trystendsmyth/nest-mini-drop-in-pcb/nest-mini-v2-drop-in-pcb.kicad_pcb

## KiCad design nest-mini-v2-drop-in-pcb.kicad_pcb (2026-09-27)

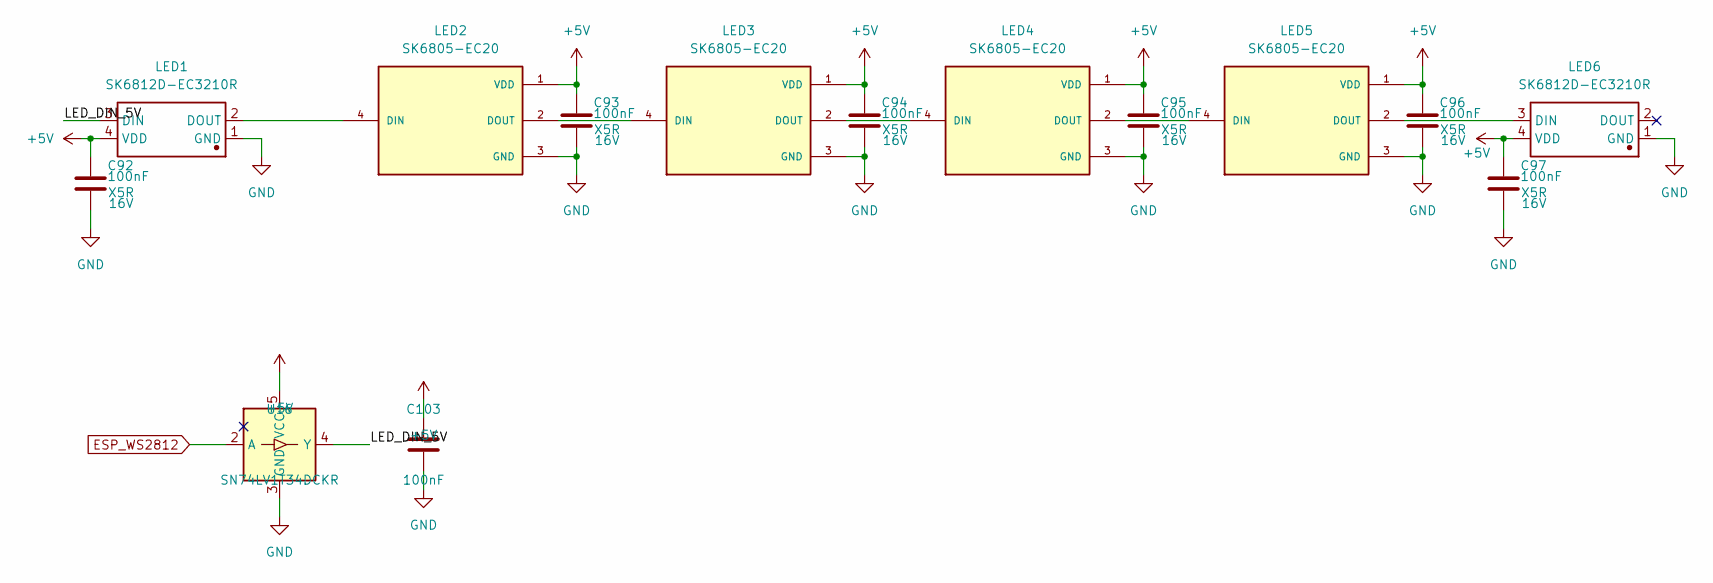
[picture p1: schematic leds.kicad_sch, Drop in replacement PCB for Nest mini GEN2]

Parts:
C92, C93, C94, C95, C96, C97: 100nF; C_0402_1005Metric; Voltage 16V; LCSC Part # C1525
C103: 100nF; C_0402_1005Metric; Manufacturer Part CL05B104KO5NNNC; LCSC Part # C1525
LED1, LED6: SK6812D-EC3210R; LED-SMD_4P_SK6812D-EC3210R; Manufacturer Part SK6812D-EC3210R; LCSC Part # C2890041
LED2, LED3, LED4, LED5: SK6805-EC20; Manufacturer Part SK6805-EC20; LCSC Part # C2890036
U16: SN74LV1T34DCKR; SOT-353_SC-70-5; MPN SN74LV1T34DCKR; LCSC Part # C78541

Connections:
+5V: C92.1, C93.1, C94.1, C95.1, C96.1, C97.1, C103.1, LED1.4 (VDD), LED2.1 (VDD), LED3.1 (VDD), LED4.1 (VDD), LED5.1 (VDD), LED6.4 (VDD), U16.5 (VCC); also elsewhere on the board
/LEDs/LED_DIN_5V: LED1.3 (DIN), U16.4 (Y)
ESP_WS2812: U16.2 (A); also elsewhere on the board
GND: C92.2, C93.2, C94.2, C95.2, C96.2, C97.2, C103.2, LED1.1 (GND), LED2.3 (GND), LED3.3 (GND), LED4.3 (GND), LED5.3 (GND), LED6.1 (GND), U16.3 (GND); also elsewhere on the board
unnamed: LED1.2 (DOUT), LED2.4 (DIN)
unnamed: LED2.2 (DOUT), LED3.4 (DIN)
unnamed: LED3.2 (DOUT), LED4.4 (DIN)
unnamed: LED4.2 (DOUT), LED5.4 (DIN)
unnamed: LED5.2 (DOUT), LED6.3 (DIN)

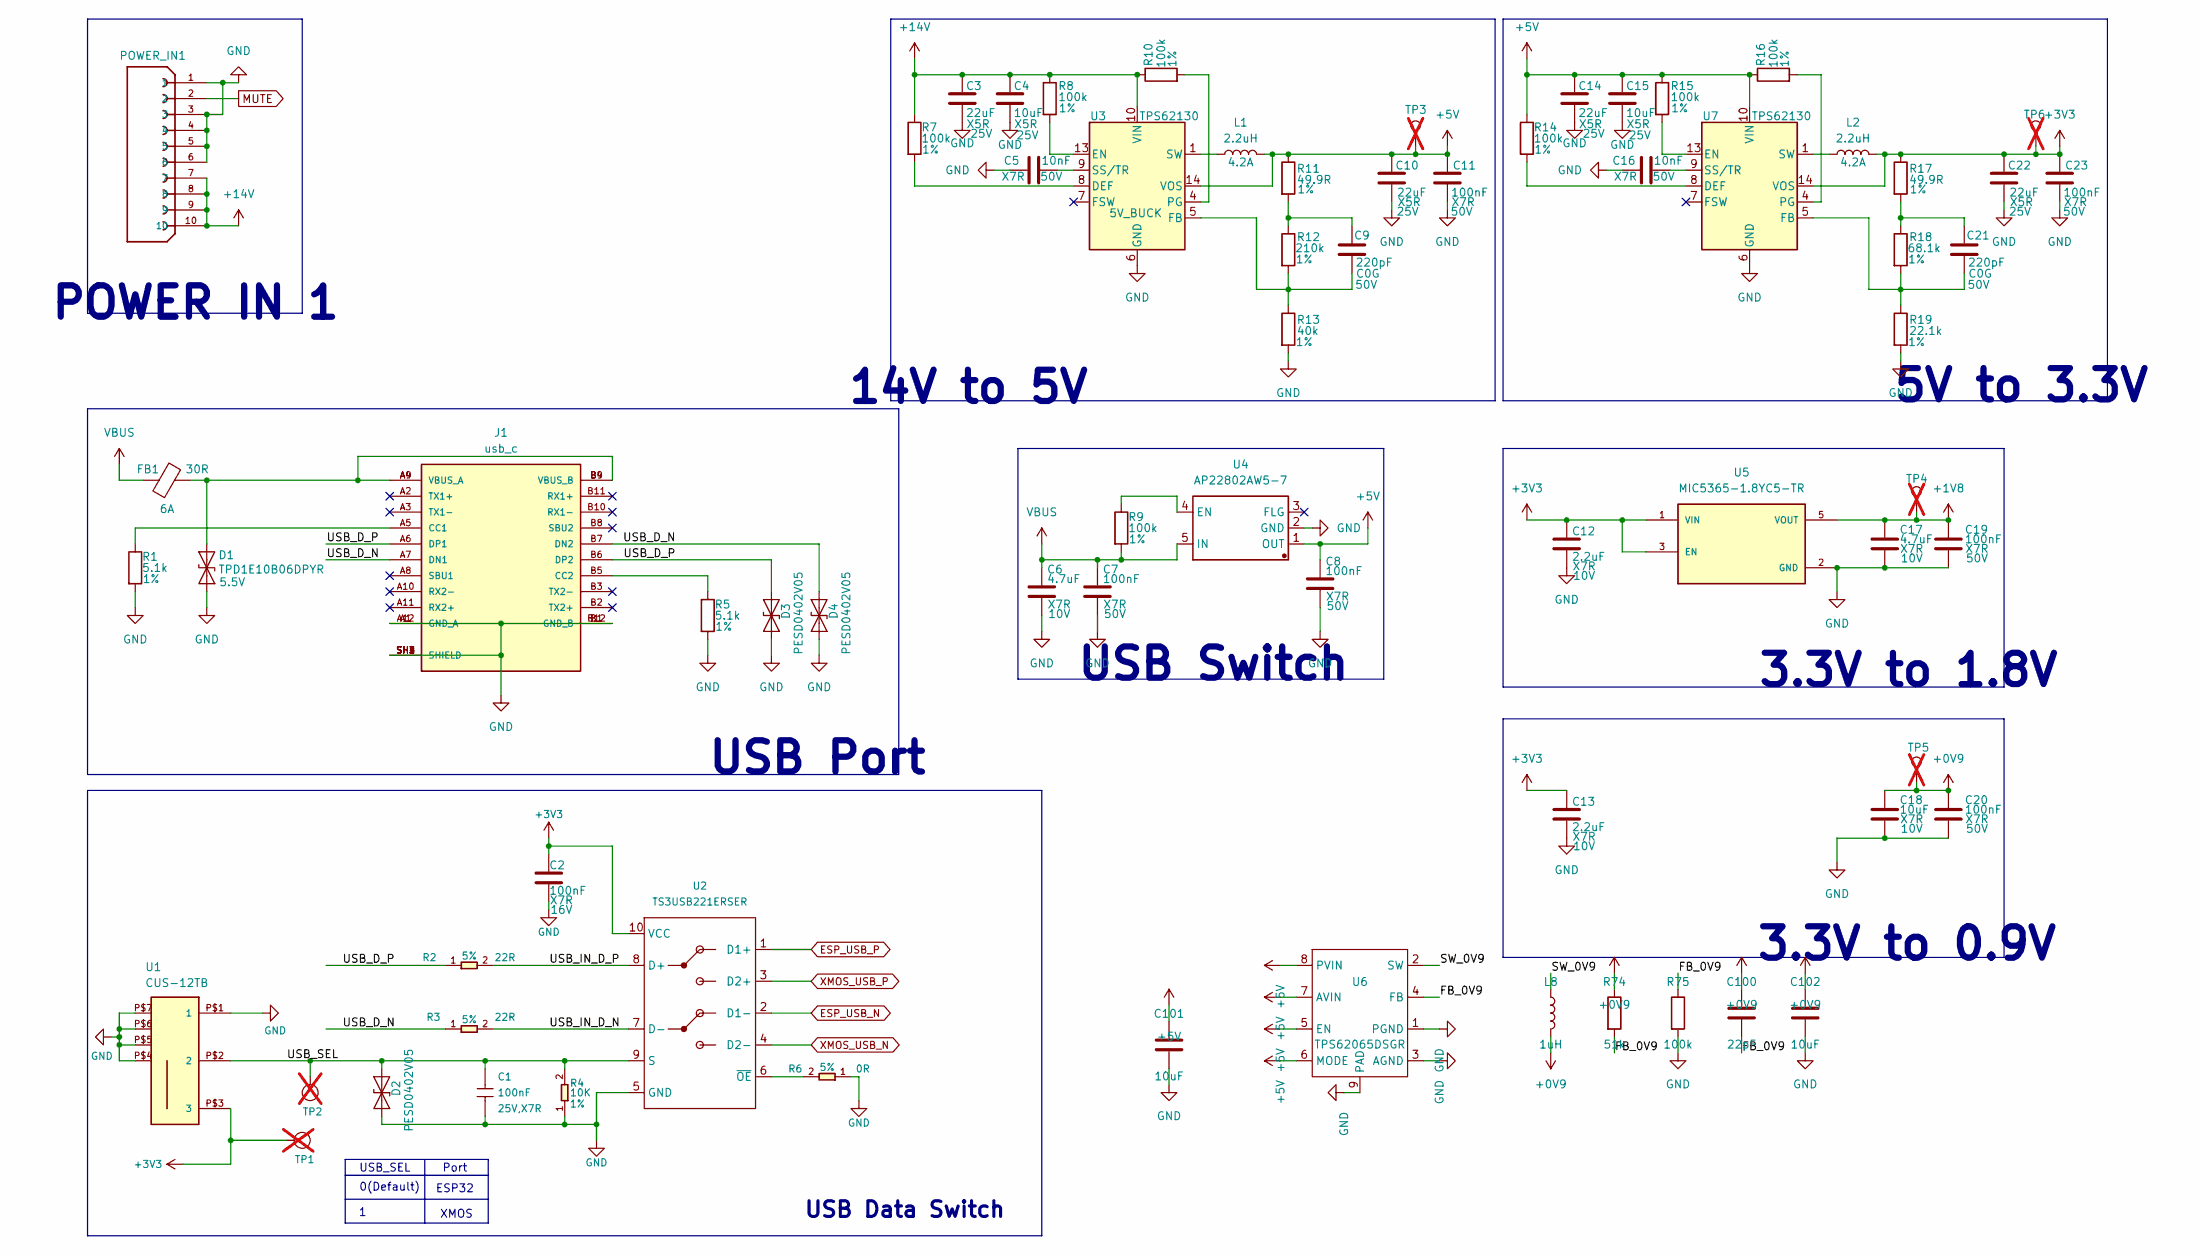
[picture p2: schematic power_handling.kicad_sch, Drop in replacement PCB for Nest mini GEN2]

Parts:
C1: 100nF; C_0402_1005Metric; Voltage Rating 25V,X7R; MPN CC0402KRX7R8BB104
C2: 100nF; C_0402_1005Metric; Voltage 16V; Manufacturer Part CL05B104KO5NNNC; LCSC Part # C1525
C3, C10, C14, C22: 22uF; C_0805_2012Metric; Voltage 25V; Manufacturer Part CL21A226MAQNNNE; LCSC Part # C45783
C4, C15: 10uF; C_0805_2012Metric; Voltage 25V; Manufacturer Part CL21A106KAYNNNE; LCSC Part # C15850
C5, C16: 10nF; C_0402_1005Metric; Voltage 50V; Manufacturer Part CL05B103KB5NNNC; LCSC Part # C15195
C6, C17: 4.7uF; C_0603_1608Metric; Voltage 10V; Manufacturer Part GRM188Z71A475KE15D; LCSC Part # C913474
C7, C8: 100nF; C_0603_1608Metric; Voltage 50V; Manufacturer Part CC0603KRX7R9BB104; LCSC Part # C14663
C9, C21: 220pF; C_0603_1608Metric; Voltage 50V; Manufacturer Part 0603CG221J500NT; LCSC Part # C156398
C11, C19, C20, C23: 100nF; C_0805_2012Metric; Voltage 50V; Manufacturer Part CC0805KRX7R9BB104; LCSC Part # C49678
C12, C13: 2.2uF; C_0603_1608Metric; Voltage 10V; Manufacturer Part GRM188R71A225KE15D; LCSC Part # C86018
C18, C101, C102: 10uF; C_0603_1608Metric; Voltage 10V; Manufacturer Part CL10A106KP8NNNC; LCSC Part # C19702
C100: 22pF; C_0402_1005Metric; Manufacturer Part CC0402JRNPO9BN220; LCSC Part # C106203
D1: TPD1E10B06DPYR; TPD1E05U06DPYR; Voltage 5.5V; Manufacturer Part TPD1E10B06DPYR; LCSC Part # C48260
D2, D4: PESD0402V05; D_0402_1005Metric; Manufacturer Part PESD0402V05; LCSC Part # C19626254
D3: PESD0402V05; D_0402_1005Metric; Part C19626254; LCSC Part # C19626254
FB1: 30R; R_0603_1608Metric; Part number BLM18PG300SN1D; LCSC Part # C17305
J1: usb_c; USB-C-SMD_TYPE-C-USB-18; Manufacturer Part 1054500101; LCSC Part # C134092
L1, L2: 2.2uH; L_Cenker_CKCS4020; Manufacturer Part SRP4020TA-2R2M; LCSC Part # C719179
L8: 1uH; L_Murata_DFE201610P; Manufacturer Part DFE201610E-1R0M=P2; LCSC Part # C161082
POWER_IN1: FH34SRJ-10S-0.5SH_50_; HRS_FH34SRJ-10S-0.5SH_50_; Manufacturer Part FH34SRJ-10S-0.5SH(50); LCSC Part # C324723
R1, R5: 5.1k; R_0402_1005Metric; Tolerance 1%; Manufacturer Part 0402WGF5101TCE; LCSC Part # C25905
R2, R3: 22R; R_0402_1005Metric; Tolerance 5%; MPN RC0402JR-0722RL
R4: 10K; R_0402_1005Metric; Tolerance 1%; MPN RC0402FR-0710KL
R6: 0R; R_0402_1005Metric; Tolerance 5%; MPN RC0402JR-070RL
R7, R8, R9, R10, R14, R15, R16: 100k; R_0402_1005Metric; Tolerance 1%; Manufacturer Part 0402WGJ0104TCE; LCSC Part # C25530
R11, R17: 49.9R; R_0603_1608Metric; Tolerance 1%; Manufacturer Part 0603WAF499JT5E; LCSC Part # C23185
R12: 210k; R_0603_1608Metric; Tolerance 1%; Manufacturer Part 0603WAF2103T5E; LCSC Part # C22952
R13: 40k; R_0603_1608Metric; Tolerance 1%; Manufacturer Part SCR0603F40K; LCSC Part # C3016445
R18: 68.1k; R_0603_1608Metric; Tolerance 1%; Manufacturer Part 0603WAF6812T5E; LCSC Part # C25976
R19: 22.1k; R_0603_1608Metric; Tolerance 1%; Manufacturer Part 0603WAF2212T5E; LCSC Part # C25961
R74: 51k; R_0402_1005Metric; Manufacturer Part RC0402FR-0751KL; LCSC Part # C107229
R75: 100k; R_0402_1005Metric; Manufacturer Part RC0402FR-07100KL; LCSC Part # C60491
TP1: Test Point; TestPoint_Pad_D1.0mm; not fitted
TP2: Test Point; TestPoint_Pad_D1.0mm; Part Type Test Point; not fitted
TP3, TP4, TP5, TP6: TestPoint; TestPoint_Pad_D1.0mm; not fitted
U1: CUS-12TB; CUS-12B
U2: TS3USB221ERSER; MPN TS3USB221ERSER; LCSC Part # C129313
U3, U7: TPS62130; VQFN-16-1EP_3x3mm_P0.5mm_EP1.68x1.68mm_ThermalVias; Manufacturer Part TPS62130ARGTR; LCSC Part # C337502
U4: AP22802AW5-7; SOT-23-5; Manufacturer Part AP22802AW5-7; LCSC Part # C211404
U5: MIC5365-1.8YC5-TR; SOT65P210X110-5N; PARTREV 3.1 - July 16, 2013; LCSC Part # C626087
U6: TPS62065DSGR; Texas_DSG0008A_WSON-8-1EP_2x2mm_P0.5mm_EP0.9x1.6mm; MPN TPS62065DSGR; LCSC Part # C398352

Connections:
+0V9: C18.1, C20.1, C100.1, C102.1, L8.2, R74.1, TP5.1; also elsewhere on the board
+1V8: C17.1, C19.1, TP4.1, U5.5 (VOUT); also elsewhere on the board
+3V3: C2.1, C12.1, C13.1, C22.1, C23.1, L2.2, R17.1, TP1.1 (T), TP6.1, U1.P$3 (3), U2.10 (VCC), U5.1 (VIN), U5.3 (EN), U7.14 (VOS); also elsewhere on the board
+5V: C8.1, C10.1, C11.1, C14.1, C15.1, C101.1, L1.2, R11.1, R14.1, R15.1, R16.1, TP3.1, U3.14 (VOS), U4.1 (OUT), U6.5 (EN), U6.6 (MODE), U6.7 (AVIN), U6.8 (PVIN), U7.10 (VIN), U7.11 (VIN), U7.12 (VIN); also elsewhere on the board
+14V: C3.1, C4.1, POWER_IN1.7, POWER_IN1.8, POWER_IN1.9, POWER_IN1.10, R7.1, R8.1, R10.1, U3.10 (VIN), U3.11 (VIN), U3.12 (VIN); also elsewhere on the board
/Power/FB_0V9: C100.2, R74.2, R75.1, U6.4 (FB)
/Power/SW_0V9: L8.1, U6.2 (SW)
/Power/USB_D_N: D4.2 (A2), J1.A7 (DN1), J1.B7 (DN2), R3.1
/Power/USB_D_P: D3.2 (A2), J1.A6 (DP1), J1.B6 (DP2), R2.1
/Power/USB_IN_D_N: R3.2, U2.7 (D-)
/Power/USB_IN_D_P: R2.2, U2.8 (D+)
/Power/USB_SEL: C1.1, D2.2 (A2), R4.2, TP2.1 (T), U1.P$2 (2), U2.9 (S)
ESP_USB_N: U2.2 (D1-); also elsewhere on the board
ESP_USB_P: U2.1 (D1+); also elsewhere on the board
GND: C1.2, C2.2, C3.2, C4.2, C5.1, C6.2, C7.2, C8.2, C10.2, C11.2, C12.2, C13.2, C14.2, C15.2, C16.1, C17.2, C18.2, C19.2, C20.2, C22.2, C23.2, C101.2, C102.2, D1.1 (A1), D2.1 (A1), D3.1 (A1), D4.1 (A1), J1.A1 (GND_A), J1.A12 (GND_A), J1.B1 (GND_B), J1.B12 (GND_B), J1.SH1 (SHIELD), J1.SH2 (SHIELD), J1.SH3 (SHIELD), J1.SH4 (SHIELD), POWER_IN1.1, POWER_IN1.3, POWER_IN1.4, POWER_IN1.5, POWER_IN1.6, R1.2, R4.1, R5.2, R6.1, R13.2, R19.2, R75.2, U1.P$1 (1), U1.P$4, U1.P$5, U1.P$6, U1.P$7, U2.5 (GND), U3.6 (GND), U3.15 (GND), U3.16 (GND), U3.17 (GND), U4.2 (GND), U5.2 (GND), U6.1 (PGND), U6.3 (AGND), U6.9 (PAD), U7.6 (GND), U7.15 (GND), U7.16 (GND), U7.17 (GND); also elsewhere on the board
MUTE: POWER_IN1.2; also elsewhere on the board
unnamed: C9.1, R11.2, R12.1
unnamed: C21.1, R17.2, R18.1
unnamed: D1.2 (A2), FB1.2, J1.A4 (VBUS_A), J1.A9 (VBUS_A), J1.B4 (VBUS_B), J1.B9 (VBUS_B)
unnamed: J1.A5 (CC1), R1.1
unnamed: J1.B5 (CC2), R5.1
unnamed: L1.1, U3.1 (SW), U3.2 (SW), U3.3 (SW)
unnamed: L2.1, U7.1 (SW), U7.2 (SW), U7.3 (SW)
unnamed: R6.2, U2.6 (~OE)
unnamed: R7.2, U3.8 (DEF)
unnamed: R8.2, U3.13 (EN)
unnamed: C9.2, R12.2, R13.1, U3.5 (FB)
unnamed: R10.2, U3.4 (PG)
unnamed: C5.2, U3.9 (SS/TR)
unnamed: R9.1, U4.4 (EN)
unnamed: R14.2, U7.8 (DEF)
unnamed: R15.2, U7.13 (EN)
unnamed: C21.2, R18.2, R19.1, U7.5 (FB)
unnamed: R16.2, U7.4 (PG)
unnamed: C16.2, U7.9 (SS/TR)
VBUS: C6.1, C7.1, FB1.1, R9.2, U4.5 (IN); also elsewhere on the board
XMOS_USB_N: U2.4 (D2-); also elsewhere on the board
XMOS_USB_P: U2.3 (D2+); also elsewhere on the board

Notes on the sheet:
USB Port
POWER IN 1
USB_SEL
14V to 5V
USB Switch
USB Data Switch
3.3V to 1.8V
ESP32
0(Default)
5V to 3.3V
3.3V to 0.9V
Port
XMOS

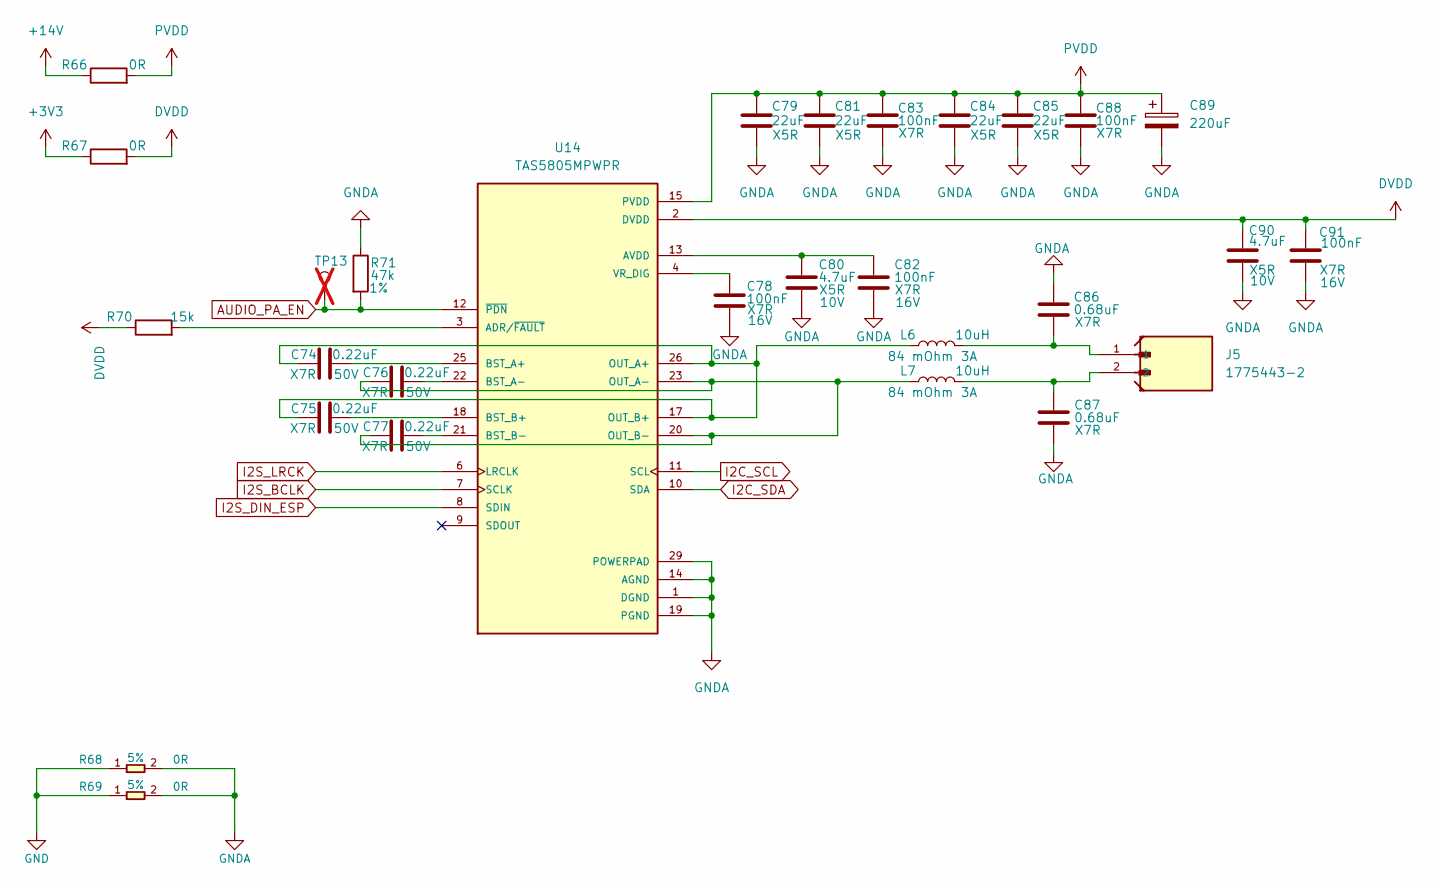
[picture p3: schematic audio.kicad_sch, Drop in replacement PCB for Nest mini GEN2]

Parts:
C74, C75, C76, C77: 0.22uF; C_0603_1608Metric; Voltage 50V
C78: 100nF; C_0402_1005Metric; Voltage 16V; Manufacturer Part CL05B104KO5NNNC; LCSC Part # C1525
C79, C81, C84, C85: 22uF; C_0805_2012Metric; Voltage 25V; Manufacturer Part GRM21BR61E226ME44L; LCSC Part # C86816
C80, C90: 4.7uF; C_0603_1608Metric; Voltage 10V
C82, C91: 100nF; C_0603_1608Metric; Voltage 16V
C83, C88: 100nF; C_0402_1005Metric; Voltage 50V; Manufacturer Part CC0402KRX7R9BB104; LCSC Part # C131394
C86, C87: 0.68uF; C_0805_2012Metric; Voltage 100V; Manufacturer Part GRM188R72A10
C89: 220uF; C_Elec_6.3x7.7; Voltage 25V; Manufacturer Part MA25V220M6X8; LCSC Part # C46550464
J5: 1775443-2; PARTREV B5; LCSC Part # C5162845
L6, L7: 10uH; XAL4040-103MEC
R66: 0R; R_1206_3216Metric
R67: 0R; R_0603_1608Metric
R68, R69: 0R; R_0805_2012Metric; Tolerance 5%; MPN 0402WGF0000TCE; LCSC Part # C17168
R70: 15k; R_0402_1005Metric; Manufacturer Part 0402WGF1502TCE; LCSC Part # C25756
R71: 47k; R_0402_1005Metric; Tolerance 1%; Manufacturer Part 0402WGF4702TCE; LCSC Part # C25792
TP13: TestPoint; TestPoint_Pad_D1.0mm; not fitted
U14: TAS5805MPWPR; Manufacturer Part TAS5805MPWPR; LCSC Part # C478472

Connections:
+3V3: R67.1; also elsewhere on the board
+14V: R66.1; also elsewhere on the board
AUDIO_PA_EN: R71.2, TP13.1, U14.12 (~PDN); also elsewhere on the board
DVDD: C90.1, C91.1, R67.2, R70.1, U14.2 (DVDD)
GND: R68.1, R69.1; also elsewhere on the board
GNDA: C78.2, C79.2, C80.2, C81.2, C82.2, C83.2, C84.2, C85.2, C86.2, C87.2, C88.2, C89.2, C90.2, C91.2, R68.2, R69.2, R71.1, U14.1 (DGND), U14.5 (DGND), U14.14 (AGND), U14.19 (PGND), U14.24 (PGND), U14.29 (POWERPAD), U14.30 (POWERPAD), U14.31 (POWERPAD), U14.32 (POWERPAD), U14.33 (POWERPAD), U14.34 (POWERPAD), U14.35 (POWERPAD), U14.36 (POWERPAD), U14.37 (POWERPAD), U14.38 (POWERPAD), U14.39 (POWERPAD), U14.40 (POWERPAD), U14.41 (POWERPAD), U14.42 (POWERPAD), U14.43 (POWERPAD), U14.44 (POWERPAD), U14.45 (POWERPAD), U14.46 (POWERPAD), U14.47 (POWERPAD), U14.48 (POWERPAD), U14.49 (POWERPAD), U14.50 (POWERPAD), U14.51 (POWERPAD), U14.52 (POWERPAD), U14.53 (POWERPAD)
I2C_SCL: U14.11 (SCL); also elsewhere on the board
I2C_SDA: U14.10 (SDA); also elsewhere on the board
I2S_BCLK: U14.7 (SCLK); also elsewhere on the board
I2S_DIN_ESP: U14.8 (SDIN); also elsewhere on the board
I2S_LRCK: U14.6 (LRCLK); also elsewhere on the board
unnamed: C86.1, J5.1, L6.2
unnamed: C87.1, J5.2, L7.2
unnamed: R70.2, U14.3 (ADR/~FAULT)
unnamed: C80.1, C82.1, U14.13 (AVDD)
unnamed: C74.2, U14.25 (BST_A+)
unnamed: C76.2, U14.22 (BST_A-)
unnamed: C75.2, U14.18 (BST_B+)
unnamed: C77.2, U14.21 (BST_B-)
unnamed: C74.1, C75.1, L6.1, U14.17 (OUT_B+), U14.26 (OUT_A+)
unnamed: C76.1, C77.1, L7.1, U14.20 (OUT_B-), U14.23 (OUT_A-)
unnamed: C78.1, U14.4 (VR_DIG)
PVDD: C79.1, C81.1, C83.1, C84.1, C85.1, C88.1, C89.1, R66.2, U14.15 (PVDD), U14.16 (PVDD), U14.27 (PVDD), U14.28 (PVDD)

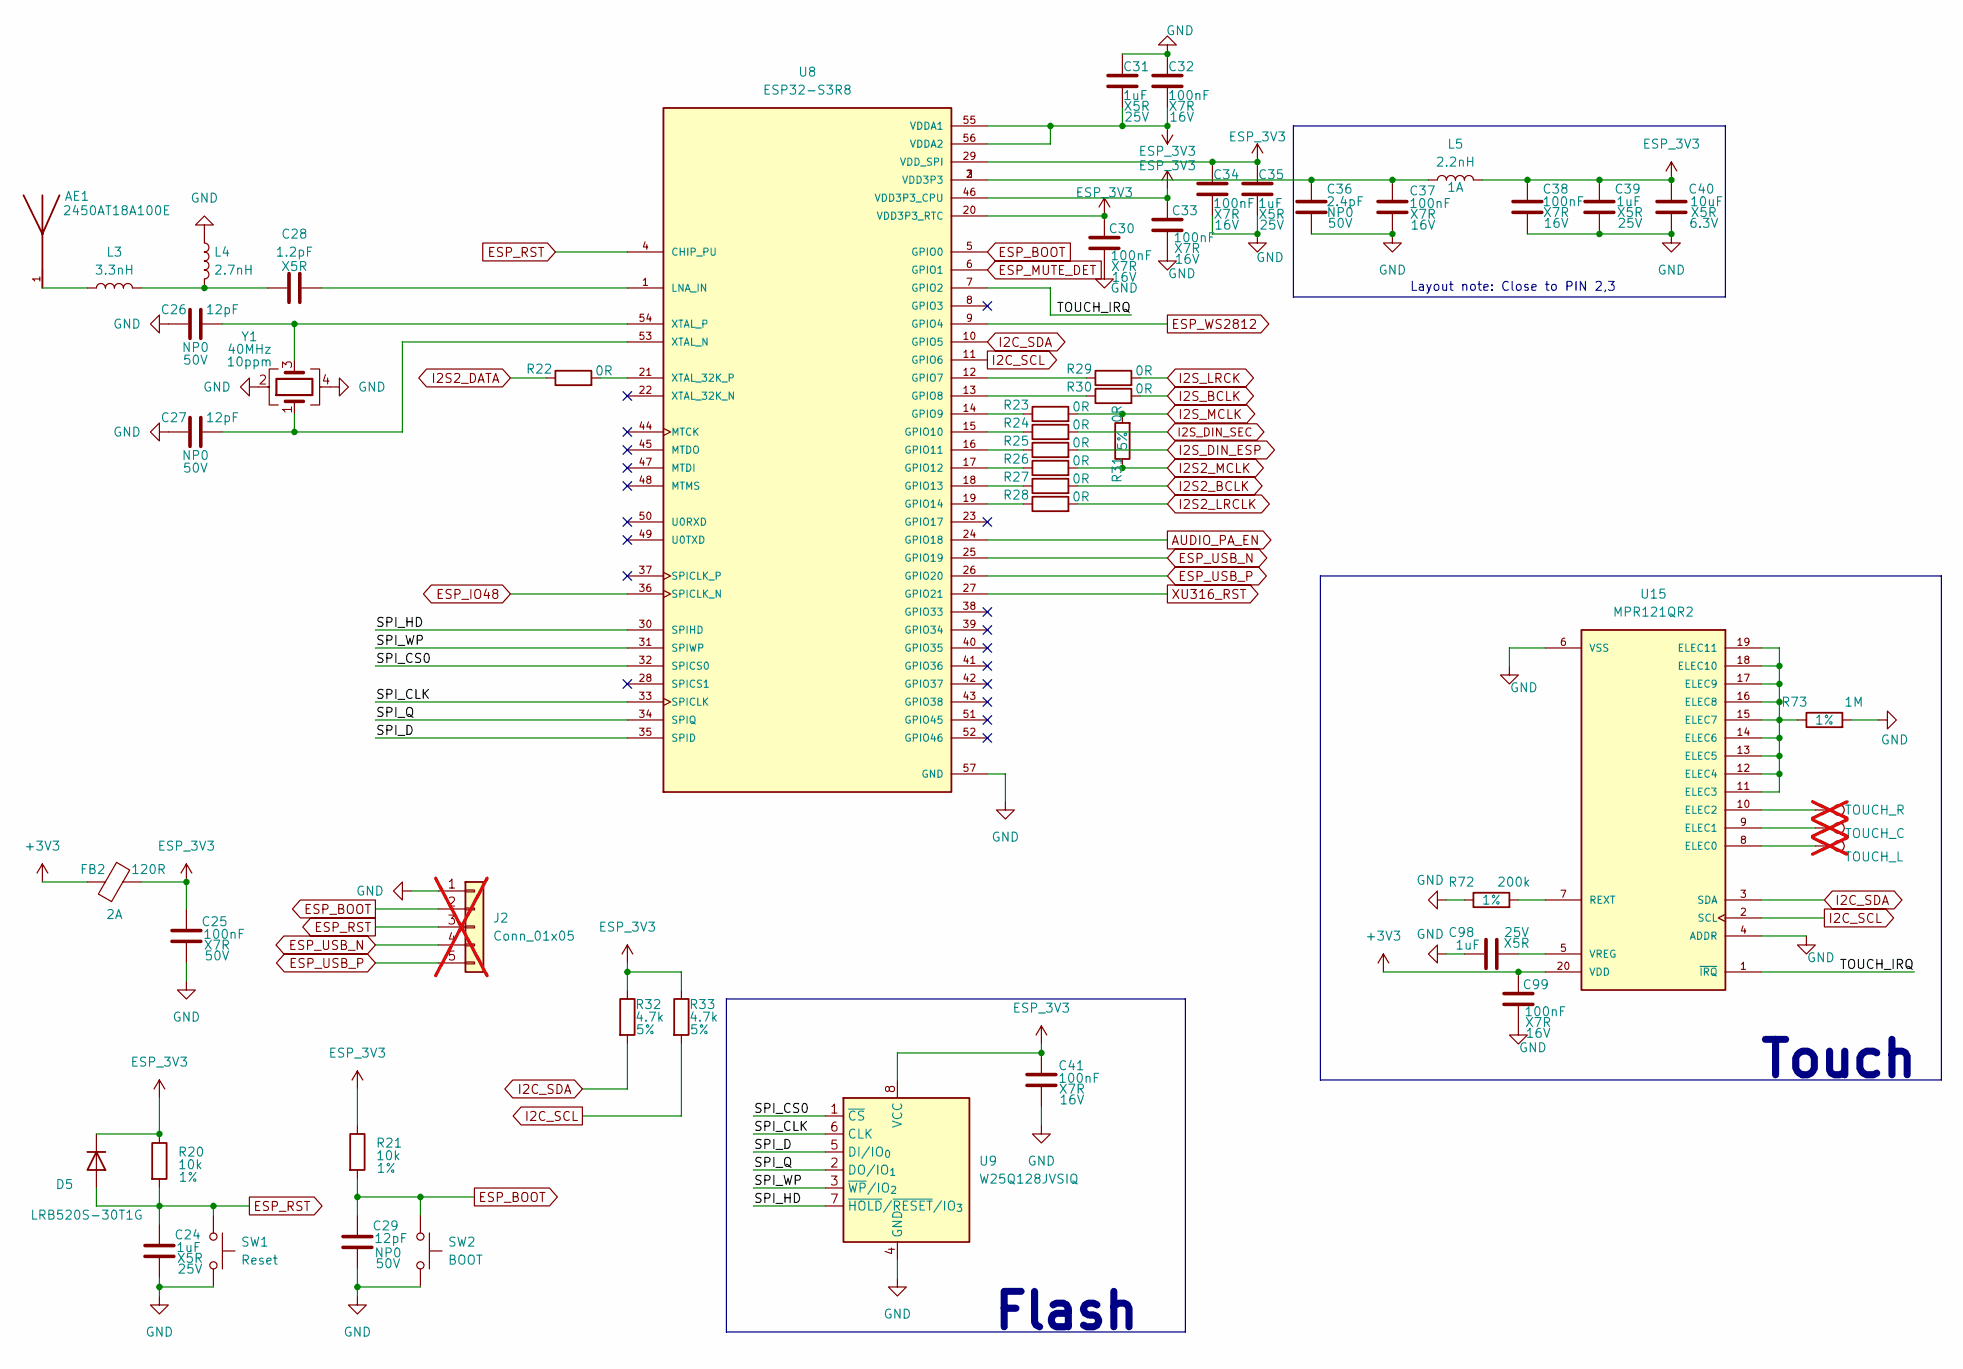
[picture p4: schematic esp32.kicad_sch, Drop in replacement PCB for Nest mini GEN2]

Parts:
AE1: 2450AT18A100E; Johanson_2450AT18x100; PARTREV 1.3; LCSC Part # C89334
C24, C31, C35, C39, C98: 1uF; C_0402_1005Metric; Voltage 25V; Manufacturer Part CL05A105KA5NQNC; LCSC Part # C52923
C25: 100nF; C_0603_1608Metric; Voltage 50V; Manufacturer Part CC0603KRX7R9BB104; LCSC Part # C14663
C26, C27, C29: 12pF; C_0402_1005Metric; Voltage 50V; Manufacturer Part 0402CG120J500NT; LCSC Part # C1547
C28: 1.2pF; C_0402_1005Metric; Voltage 10V; Manufacturer Part CC0402BRNPO9BN1R2; LCSC Part # C327292
C30, C32, C33, C34, C37, C38, C41, C99: 100nF; C_0402_1005Metric; Voltage 16V; Manufacturer Part CL05B104KO5NNNC; LCSC Part # C1525
C36: 2.4pF; C_0402_1005Metric; Voltage 50V; Manufacturer Part 0402CG2R4C500NT; LCSC Part # C48346
C40: 10uF; C_0402_1005Metric; Voltage 6.3V; Manufacturer Part CL05A106MQ5NUNC; LCSC Part # C15525
D5: LRB520S-30T1G; D_SOD-523; Manufacturer Part LRB520S-30T1G; LCSC Part # C83680
FB2: 120R; BLM18PG121SN1D; Part number BLM18PG121SN1D; LCSC Part # C14709
J2: Conn_01x05; PinHeader_1x05_P2.54mm_Vertical; not fitted
L3: 3.3nH; L_0402_1005Metric; Manufacturer Part SDCL1005C3N3STDF; LCSC Part # C16526
L4: 2.7nH; L_0402_1005Metric; Manufacturer Part MHQ1005P2N7BT000; LCSC Part # C434826
L5: 2.2nH; L_0402_1005Metric; Manufacturer Part LQG15HS2N2B02D; LCSC Part # C162540
R20, R21: 10k; R_0402_1005Metric; Tolerance 1%; Manufacturer Part 0402WGF1002TCE; LCSC Part # C25744
R22, R23, R24, R25, R26, R27, R28, R29, R30, R31: 0R; R_0402_1005Metric; Tolerance 5%; Manufacturer Part 0402WGF0000TCE; LCSC Part # C17168
R32, R33: 4.7k; R_0402_1005Metric; Tolerance 5%; Manufacturer Part 0402WGF4701TCE; LCSC Part # C25900
R72: 200k; R_0402_1005Metric; Tolerance 1%; MPN 0402WGF2003TCE; LCSC Part # C25764
R73: 1M; R_0402_1005Metric; Tolerance 1%; MPN 0402WGJ0105TCE; LCSC Part # C26087
SW1: Reset; SW-SMD_4P-L4.2-W3.2-P2.15-LS4.5; Manufacturer Part PTS810SJS250SMTRLFS; LCSC Part # C221897
SW2: BOOT; SW-SMD_4P-L4.2-W3.2-P2.15-LS4.5; Manufacturer Part PTS810SJS250SMTRLFS; LCSC Part # C221897
TP14: TOUCH_R; TestPoint_Pad_2.5x2.5mm; not fitted
TP15: TOUCH_C; TestPoint_Pad_2.5x2.5mm; not fitted
TP16: TOUCH_L; TestPoint_Pad_2.5x2.5mm; not fitted
U8: ESP32-S3R8; QFN40P700X700X90-57N; Manufacturer Part ESP32-S3R8; LCSC Part # C2913194
U9: W25Q128JVSIQ; SOIC-8_5.3x5.3mm_P1.27mm; Manufacturer Part W25Q128JVSIQ; LCSC Part # C97521
U15: MPR121QR2; MPN MPR121QR2; LCSC Part # C91322
Y1: 40MHz; Crystal_SMD_2016-4Pin_2.0x1.6mm; Tolerance 10ppm; Manufacturer Part TAXM40M4ZCBCDT2T; LCSC Part # C424431

Connections:
+3V3: C99.1, FB2.1, U15.20 (VDD); also elsewhere on the board
/ESP32-S3R8/SPI_CLK: U8.33 (SPICLK), U9.6 (CLK)
/ESP32-S3R8/SPI_CS0: U8.32 (SPICS0), U9.1 (~CS)
/ESP32-S3R8/SPI_D: U8.35 (SPID), U9.5 (DI/IO_{0})
/ESP32-S3R8/SPI_HD: U8.30 (SPIHD), U9.7 (~HOLD/~RESET/IO_{3})
/ESP32-S3R8/SPI_Q: U8.34 (SPIQ), U9.2 (DO/IO_{1})
/ESP32-S3R8/SPI_WP: U8.31 (SPIWP), U9.3 (~WP/IO_{2})
/ESP32-S3R8/TOUCH_IRQ: U8.7 (GPIO2), U15.1 (~IRQ)
AUDIO_PA_EN: U8.24 (GPIO18); also elsewhere on the board
ESP_3V3: C25.1, C30.1, C31.2, C32.2, C33.1, C34.1, C35.1, C38.1, C39.1, C40.1, C41.1, D5.1 (K), FB2.2, L5.2, R20.1, R21.1, R32.1, R33.1, U8.20 (VDD3P3_RTC), U8.29 (VDD_SPI), U8.46 (VDD3P3_CPU), U8.55 (VDDA1), U8.56 (VDDA2), U9.8 (VCC); also elsewhere on the board
ESP_BOOT: C29.1, J2.2, R21.2, SW2.1, U8.5 (GPIO0)
ESP_IO48: U8.36 (SPICLK_N)
ESP_MUTE_DET: U8.6 (GPIO1); also elsewhere on the board
ESP_RST: C24.1, D5.2 (A), J2.3, R20.2, SW1.1, U8.4 (CHIP_PU)
ESP_USB_N: J2.4, U8.25 (GPIO19); also elsewhere on the board
ESP_USB_P: J2.5, U8.26 (GPIO20); also elsewhere on the board
ESP_WS2812: U8.9 (GPIO4); also elsewhere on the board
GND: C24.2, C25.2, C26.1, C27.1, C29.2, C30.2, C31.1, C32.1, C33.2, C34.2, C35.2, C36.2, C37.2, C38.2, C39.2, C40.2, C41.2, C98.1, C99.2, J2.1, L4.1, R72.1, R73.2, SW1.2, SW2.2, U8.57 (GND), U9.4 (GND), U15.4 (ADDR), U15.6 (VSS), Y1.2, Y1.4; also elsewhere on the board
I2C_SCL: R33.2, U8.11 (GPIO6), U15.2 (SCL); also elsewhere on the board
I2C_SDA: R32.2, U8.10 (GPIO5), U15.3 (SDA); also elsewhere on the board
I2S2_BCLK: R27.2; also elsewhere on the board
I2S2_DATA: R22.1; also elsewhere on the board
I2S2_LRCLK: R28.2; also elsewhere on the board
I2S2_MCLK: R26.2, R31.1; also elsewhere on the board
I2S_BCLK: R30.2; also elsewhere on the board
I2S_DIN_ESP: R25.2; also elsewhere on the board
I2S_DIN_SEC: R24.2; also elsewhere on the board
I2S_LRCK: R29.2; also elsewhere on the board
I2S_MCLK: R23.2, R31.2
unnamed: AE1.1, L3.1
unnamed: C28.1, L3.2, L4.2
unnamed: C36.1, C37.1, L5.1, U8.2 (VDD3P3), U8.3 (VDD3P3)
unnamed: R29.1, U8.12 (GPIO7)
unnamed: R30.1, U8.13 (GPIO8)
unnamed: R23.1, U8.14 (GPIO9)
unnamed: R24.1, U8.15 (GPIO10)
unnamed: R25.1, U8.16 (GPIO11)
unnamed: R26.1, U8.17 (GPIO12)
unnamed: R27.1, U8.18 (GPIO13)
unnamed: R28.1, U8.19 (GPIO14)
unnamed: C28.2, U8.1 (LNA_IN)
unnamed: R22.2, U8.21 (XTAL_32K_P)
unnamed: C27.2, U8.53 (XTAL_N), Y1.1
unnamed: C26.2, U8.54 (XTAL_P), Y1.3
unnamed: TP16.1, U15.8 (ELEC0)
unnamed: TP15.1, U15.9 (ELEC1)
unnamed: TP14.1, U15.10 (ELEC2)
unnamed: R73.1, U15.11 (ELEC3), U15.12 (ELEC4), U15.13 (ELEC5), U15.14 (ELEC6), U15.15 (ELEC7), U15.16 (ELEC8), U15.17 (ELEC9), U15.18 (ELEC10), U15.19 (ELEC11)
unnamed: R72.2, U15.7 (REXT)
unnamed: C98.2, U15.5 (VREG)
XU316_RST: U8.27 (GPIO21); also elsewhere on the board

Notes on the sheet:
Touch
Layout note: Close to PIN 2,3
Flash
