trystendsmyth/nest-mini-drop-in-pcb/nest-mini-v2-drop-in-pcb.kicad_pcb

## KiCad design nest-mini-v2-drop-in-pcb.kicad_pcb (continued)

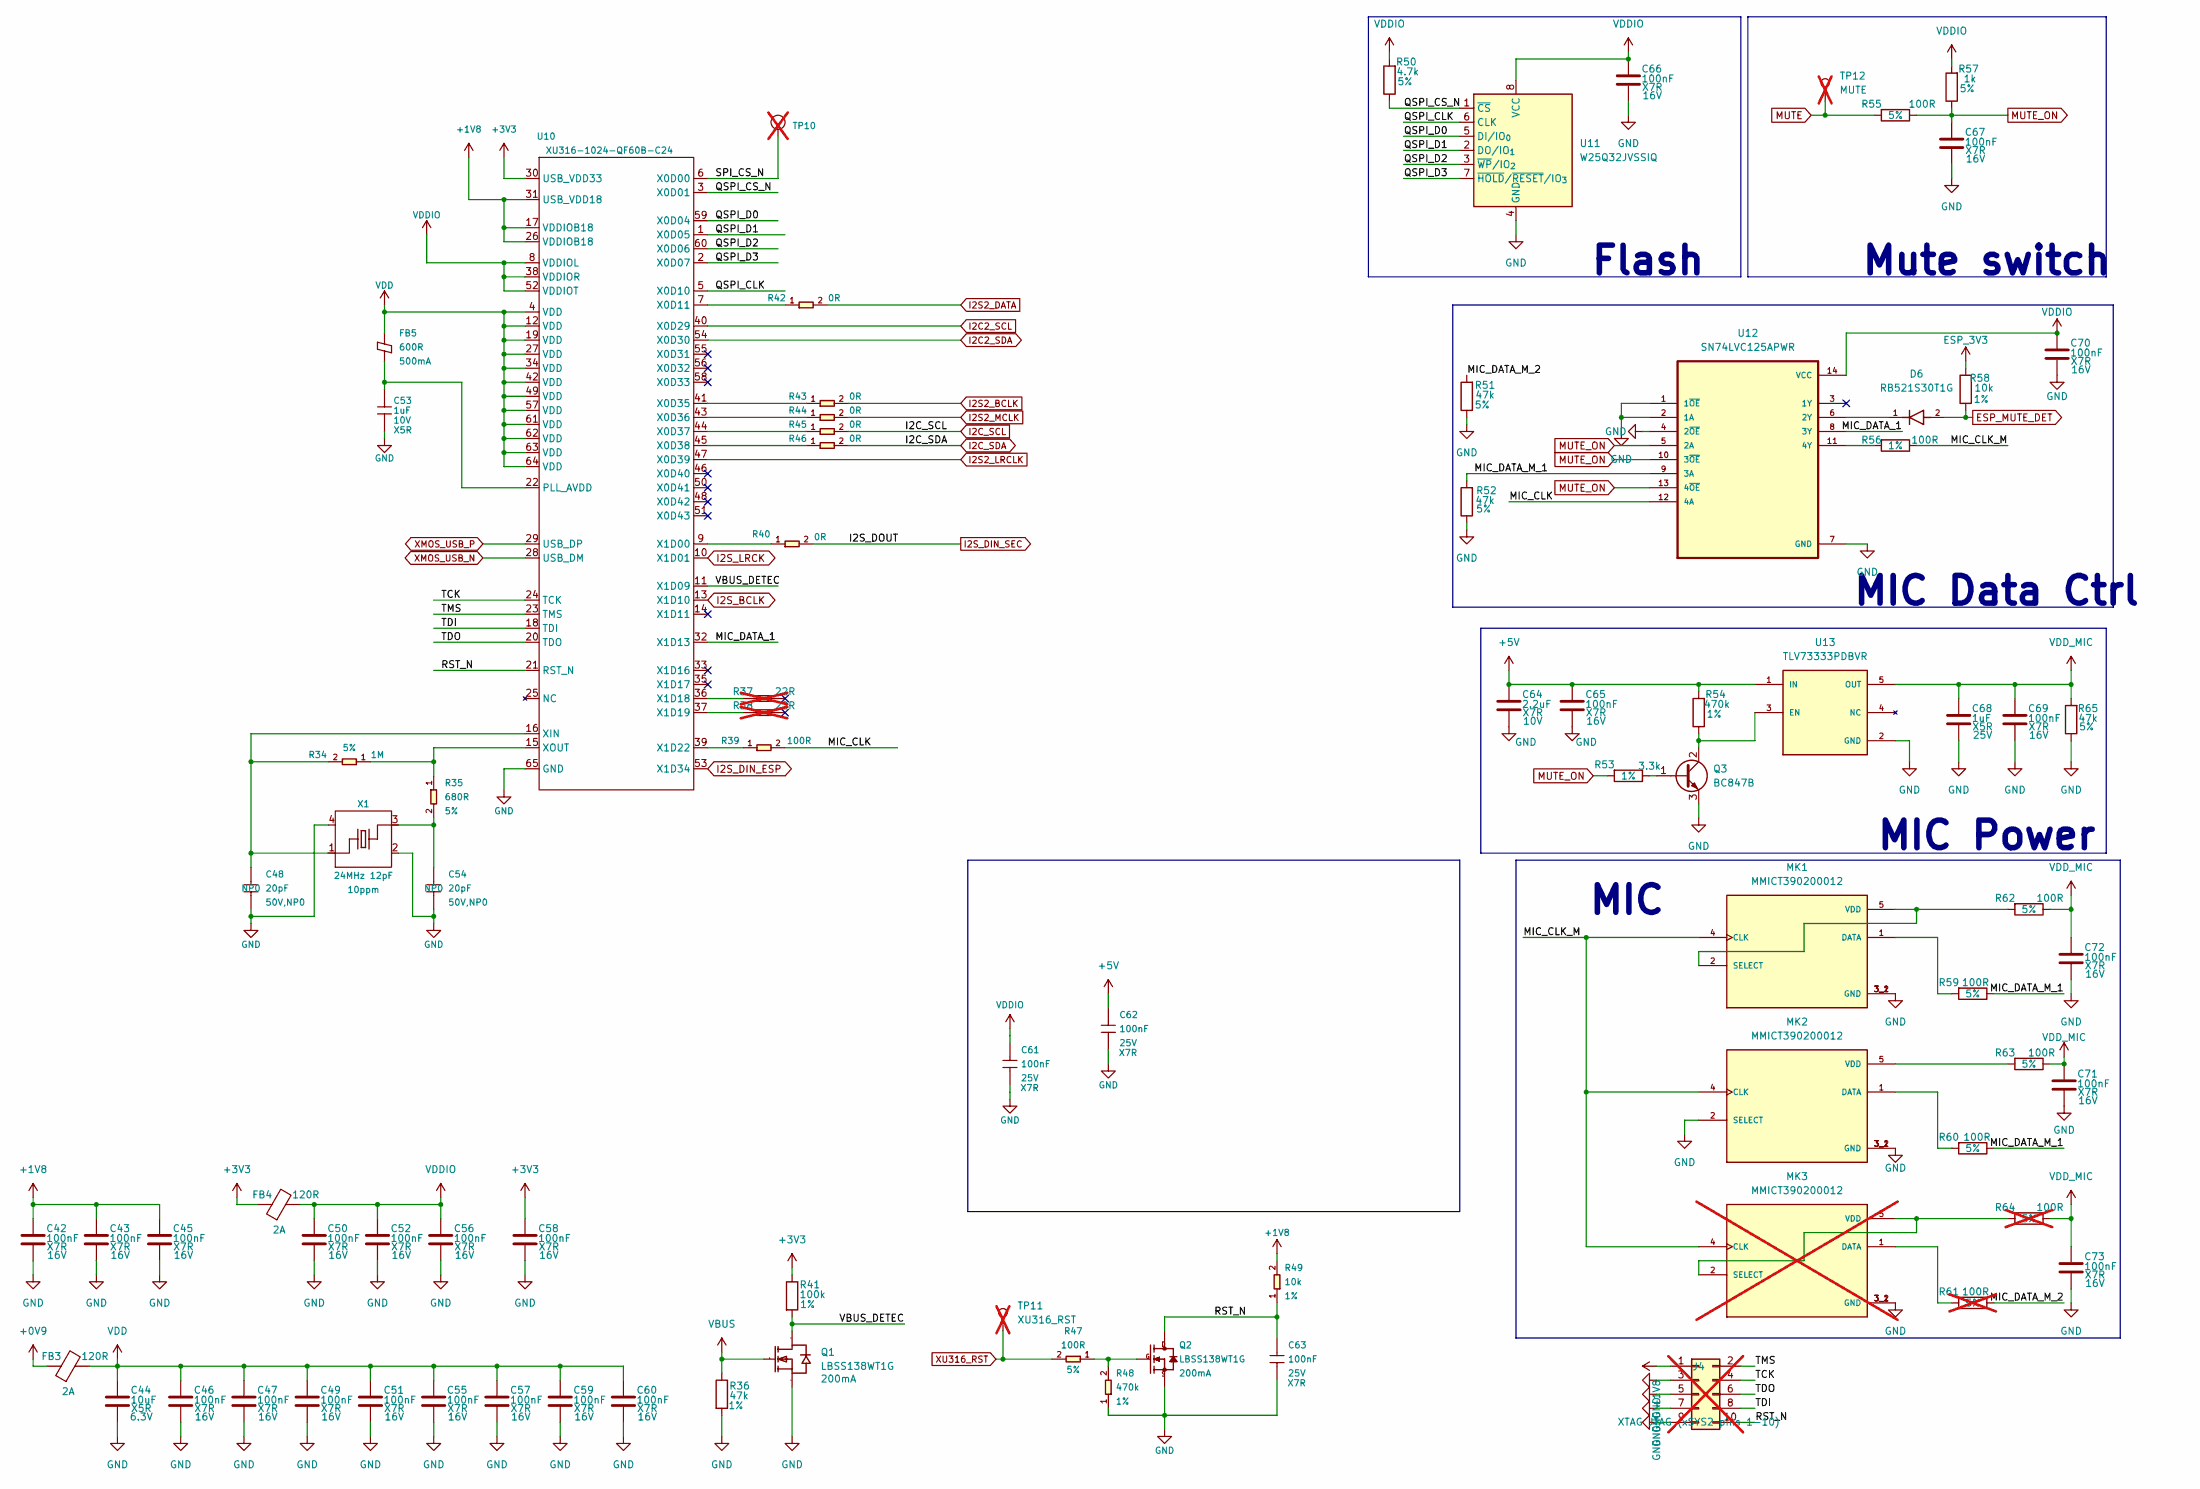
[picture p5: schematic xmos.kicad_sch, Drop in replacement PCB for Nest mini GEN2]

Parts:
C42, C43, C45, C46, C47, C49, C50, C51, C52, C55, C56, C57, C58, C59, C60, C65, C66, C67, C69, C70, C71, C72, C73: 100nF; C_0402_1005Metric; Voltage 16V; Manufacturer Part CL05B104KO5NNNC; LCSC Part # C1525
C44: 10uF; C_0402_1005Metric; Voltage 6.3V; Manufacturer Part CL05A106MQ5NUNC; LCSC Part # C15525
C48, C54: 20pF; C_0402_1005Metric; Voltage Rating 50V,NP0; Voltage 50V; MPN 0402CG200J500NT; LCSC Part # C1554
C53: 1uF; C_0402_1005Metric; Voltage Rating 10V; Voltage 25V; MPN CL05A105KA5NQNC; LCSC Part # C52923
C61, C62: 100nF; C_0402_1005Metric; Voltage Rating 25V; Voltage 16V; MPN CL05B104KO5NNNC; LCSC Part # C1525
C63: 100nF; C_0402_1005Metric; Voltage Rating 25V; MPN CC0402KRX7R8BB104; LCSC Part # C1525
C64: 2.2uF; C_0603_1608Metric; Voltage 10V; Manufacturer Part GRM188R71A225KE15D; LCSC Part # C86018
C68: 1uF; C_0402_1005Metric; Voltage 25V; Manufacturer Part CL05A105KA5NQNC; LCSC Part # C52923
D6: RB521S30T1G; DIOM168X70N; PARTREV 7/11/1905; LCSC Part # C27636108
FB3: 120R; BLM18PG121SN1D; Part number BLM18PG121SN1D; LCSC Part # C14709
FB4: 120R; BLM18PG121SN1D; Part number BLM18AG121SN1D; LCSC Part # C14709
FB5: 600R; BLM18PG121SN1D; Rating 500mA; MPN BLM18KG601SN1D; LCSC Part # C85833
J4: XTAG JTAG (xSYS2 pins 1-10); PinHeader_2x05_P1.27mm_Vertical; not fitted
MK1, MK2: MMICT390200012; MIC_T3902; PARTREV 1.0; LCSC Part # C3171752
MK3: MMICT390200012; MIC_T3902; PARTREV 1.0; LCSC Part # C3171752; not fitted
Q1: LBSS138WT1G; SC-70-3_L2.1-W1.3-P0.65-LS2.1-BR; Manufacturer Part LBSS138WT1G; LCSC Part # C383201
Q2: LBSS138WT1G; SOT-323_SC-70; Rating 200mA; MPN LBSS138WT1G; LCSC Part # C383201
Q3: BC847B; SOT-23; Manufacturer Part BC847B; LCSC Part # C20069135
R34: 1M; R_0402_1005Metric; Power Rating 5%; MPN 0402WGF1004TCE; LCSC Part # C26083
R35: 680R; R_0402_1005Metric; Power Rating 5%; MPN 0402WGF6800TCE; LCSC Part # C25130
R36: 47k; R_0402_1005Metric; Tolerance 1%; Manufacturer Part 0402WGF4702TCE; LCSC Part # C25792
R37, R38: 22R; R_0402_1005Metric; Power Rating 5%; MPN 0402WGF220JTCE; LCSC Part # C25092; not fitted
R39: 100R; R_0402_1005Metric; Power Rating 5%; MPN 0402WGF1000TCE; LCSC Part # C25076
R40, R43, R44, R45, R46: 0R; R_0402_1005Metric; Power Rating 5%; MPN 0402WGF0000TCE; LCSC Part # C17168
R41: 100k; R_0402_1005Metric; Tolerance 1%; Manufacturer Part 0402WGJ0104TCE; LCSC Part # C25530
R42: 0R; R_0402_1005Metric; Tolerance 5%; MPN 0402WGF0000TCE; LCSC Part # C17168
R47: 100R; R_0402_1005Metric; Power Rating 5%; MPN RC0402JR-07100RL; LCSC Part # C25076
R48: 470k; R_0402_1005Metric; Power Rating 1%; MPN RC0402FR-07470KL; LCSC Part # C25790
R49: 10k; R_0402_1005Metric; Power Rating 1%; MPN RC0402FR-0710KL; LCSC Part # C25744
R50: 4.7k; R_0402_1005Metric; Tolerance 5%; Manufacturer Part 0402WGF4701TCE; LCSC Part # C25900
R51, R52, R65: 47k; R_0402_1005Metric; Tolerance 5%; Manufacturer Part 0402WGF4702TCE; LCSC Part # C25792
R53: 3.3k; R_0402_1005Metric; Tolerance 1%; Manufacturer Part 0402WGF3301TCE; LCSC Part # C25890
R54: 470k; R_0402_1005Metric; Tolerance 1%; Manufacturer Part 0402WGF4703TCE; LCSC Part # C25790
R55, R59, R60, R62, R63: 100R; R_0402_1005Metric; Tolerance 5%; Manufacturer Part 0402WGF1000TCE; LCSC Part # C25076
R56: 100R; R_0402_1005Metric; Tolerance 1%; Manufacturer Part 0402WGF1000TCE; LCSC Part # C25076
R57: 1k; R_0402_1005Metric; Tolerance 5%; Manufacturer Part 0402WGF1001TCE; LCSC Part # C11702
R58: 10k; R_0402_1005Metric; Tolerance 1%; Manufacturer Part 0402WGF1002TCE; LCSC Part # C25744
R61, R64: 100R; R_0402_1005Metric; Tolerance 5%; Manufacturer Part 0402WGF1000TCE; LCSC Part # C25076; not fitted
TP10: TEST-POINT; TestPoint_Pad_D1.0mm; not fitted
TP11: XU316_RST; TestPoint_Pad_D1.0mm; not fitted
TP12: MUTE; TestPoint_Pad_D1.0mm; not fitted
U10: XU316-1024-QF60B-C24 ; XU316-1024-QF60B-C24; MPN XU316-1024-QF60B-C24; LCSC Part # C6617472
U11: W25Q32JVSSIQ; SOIC-8_5.3x5.3mm_P1.27mm; Manufacturer Part W25Q32JVSSIQ; LCSC Part # C179173
U12: SN74LVC125APWR; SOP65P640X120-14N; Manufacturer Part SN74LVC125APWR; LCSC Part # C7813
U13: TLV73333PDBVR; PARTREV C; LCSC Part # C134139
X1: 24MHz 12pF; X4-SMD-2.0X1.6MM; Rating 10ppm; MPN 7F24000E12UCG; LCSC Part # C252273

Connections:
+0V9: FB3.1; also elsewhere on the board
+1V8: C42.1, C43.1, C45.1, J4.1, R49.2, U10.17 (VDDIOB18), U10.26 (VDDIOB18), U10.31 (USB_VDD18); also elsewhere on the board
+3V3: C58.1, FB4.1, R41.1, U10.30 (USB_VDD33); also elsewhere on the board
+5V: C62.1, C64.1, C65.1, R54.2, U13.1 (IN); also elsewhere on the board
/XMOS/MIC_CLK: R39.2, U12.12 (4A)
/XMOS/MIC_CLK_M: MK1.4 (CLK), MK2.4 (CLK), MK3.4 (CLK), R56.1
/XMOS/MIC_DATA_1: U10.32 (X1D13), U12.8 (3Y)
/XMOS/MIC_DATA_M_1: R52.2, R59.1, R60.1, U12.9 (3A)
/XMOS/MIC_DATA_M_2: R51.2, R61.1
/XMOS/QSPI_CLK: U10.5 (X0D10), U11.6 (CLK)
/XMOS/QSPI_CS_N: R50.1, U10.3 (X0D01), U11.1 (~CS)
/XMOS/QSPI_D0: U10.59 (X0D04), U11.5 (DI/IO_{0})
/XMOS/QSPI_D1: U10.1 (X0D05), U11.2 (DO/IO_{1})
/XMOS/QSPI_D2: U10.60 (X0D06), U11.3 (~WP/IO_{2})
/XMOS/QSPI_D3: U10.2 (X0D07), U11.7 (~HOLD/~RESET/IO_{3})
/XMOS/RST_N: C63.1, J4.10, Q2.3 (D), R49.1, U10.21 (RST_N)
/XMOS/SPI_CS_N: TP10.1 (T), U10.6 (X0D00)
/XMOS/TCK: J4.4, U10.24 (TCK)
/XMOS/TDI: J4.8, U10.18 (TDI)
/XMOS/TDO: J4.6, U10.20 (TDO)
/XMOS/TMS: J4.2, U10.23 (TMS)
/XMOS/VBUS_DETEC: Q1.3 (D), R41.2, U10.11 (X1D09)
ESP_3V3: R58.2; also elsewhere on the board
ESP_MUTE_DET: D6.2, R58.1; also elsewhere on the board
GND: C42.2, C43.2, C44.2, C45.2, C46.2, C47.2, C48.2, C49.2, C50.2, C51.2, C52.2, C53.2, C54.2, C55.2, C56.2, C57.2, C58.2, C59.2, C60.2, C61.2, C62.2, C63.2, C64.2, C65.2, C66.2, C67.2, C68.2, C69.2, C70.2, C71.2, C72.2, C73.2, J4.3, J4.5, J4.7, J4.9, MK1.3_1 (GND), MK1.3_2 (GND), MK2.2 (SELECT), MK2.3_1 (GND), MK2.3_2 (GND), MK3.3_1 (GND), MK3.3_2 (GND), Q1.2 (S), Q2.2 (S), Q3.3 (E), R36.2, R48.1, R51.1, R52.1, R65.1, U10.65 (GND), U11.4 (GND), U12.1 (1~OE), U12.2 (1A), U12.4 (2~OE), U12.7 (GND), U13.2 (GND), X1.2, X1.4; also elsewhere on the board
I2C2_SCL: U10.40 (X0D29)
I2C2_SDA: U10.54 (X0D30)
I2C_SCL: R45.2; also elsewhere on the board
I2C_SDA: R46.2; also elsewhere on the board
I2S2_BCLK: R43.2; also elsewhere on the board
I2S2_DATA: R42.2; also elsewhere on the board
I2S2_LRCLK: U10.47 (X0D39); also elsewhere on the board
I2S2_MCLK: R44.2; also elsewhere on the board
I2S_BCLK: U10.13 (X1D10); also elsewhere on the board
I2S_DIN_ESP: U10.53 (X1D34); also elsewhere on the board
I2S_DIN_SEC: R40.2; also elsewhere on the board
I2S_LRCK: U10.10 (X1D01); also elsewhere on the board
MUTE: R55.2, TP12.1; also elsewhere on the board
MUTE_ON: C67.1, R53.2, R55.1, R57.1, U12.5 (2A), U12.10 (3~OE), U12.13 (4~OE)
unnamed: C54.1, R35.2, X1.3
unnamed: MK1.1 (DATA), R59.2
unnamed: MK1.2 (SELECT), MK1.5 (VDD), R62.2
unnamed: MK2.1 (DATA), R60.2
unnamed: MK2.5 (VDD), R63.2
unnamed: MK3.1 (DATA), R61.2
unnamed: MK3.2 (SELECT), MK3.5 (VDD), R64.2
unnamed: Q2.1 (G), R47.1, R48.2
unnamed: Q3.1 (B), R53.1
unnamed: Q3.2 (C), R54.1, U13.3 (EN)
unnamed: C53.1, FB5.1, U10.22 (PLL_AVDD)
unnamed: R42.1, U10.7 (X0D11)
unnamed: R43.1, U10.41 (X0D35)
unnamed: R44.1, U10.43 (X0D36)
unnamed: R45.1, U10.44 (X0D37)
unnamed: R46.1, U10.45 (X0D38)
unnamed: R40.1, U10.9 (X1D00)
unnamed: R37.1, U10.36 (X1D18)
unnamed: R38.1, U10.37 (X1D19)
unnamed: R39.1, U10.39 (X1D22)
unnamed: C48.1, R34.2, U10.16 (XIN), X1.1
unnamed: R34.1, R35.1, U10.15 (XOUT)
unnamed: D6.1, U12.6 (2Y)
unnamed: R56.2, U12.11 (4Y)
VBUS: Q1.1 (G), R36.1; also elsewhere on the board
VDD: C44.1, C46.1, C47.1, C49.1, C51.1, C55.1, C57.1, C59.1, C60.1, FB3.2, FB5.2, U10.4 (VDD), U10.12 (VDD), U10.19 (VDD), U10.27 (VDD), U10.34 (VDD), U10.42 (VDD), U10.49 (VDD), U10.57 (VDD), U10.61 (VDD), U10.62 (VDD), U10.63 (VDD), U10.64 (VDD)
VDDIO: C50.1, C52.1, C56.1, C61.1, C66.1, C70.1, FB4.2, R50.2, R57.2, U10.8 (VDDIOL), U10.38 (VDDIOR), U10.52 (VDDIOT), U11.8 (VCC), U12.14 (VCC)
VDD_MIC: C68.1, C69.1, C71.1, C72.1, C73.1, R62.1, R63.1, R64.1, R65.2, U13.5 (OUT)
XMOS_USB_N: U10.28 (USB_DM); also elsewhere on the board
XMOS_USB_P: U10.29 (USB_DP); also elsewhere on the board
XU316_RST: R47.2, TP11.1; also elsewhere on the board

Notes on the sheet:
Flash
MIC
Mute switch
MIC Power
MIC Data Ctrl

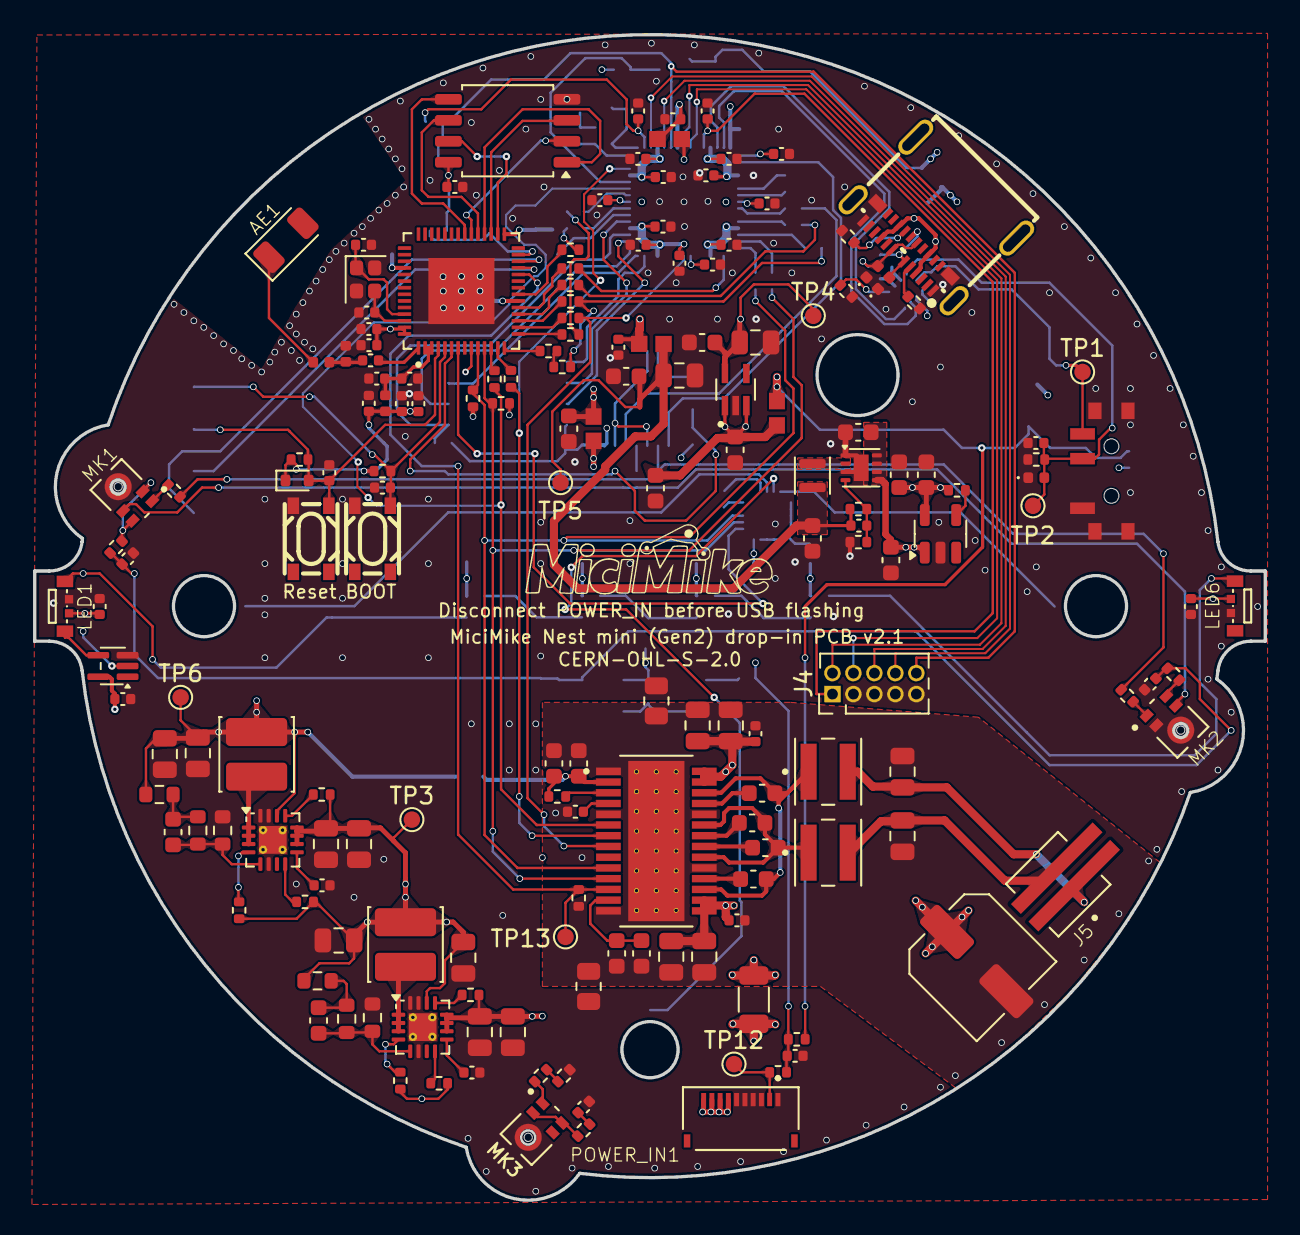
[picture p6: board nest-mini-v2-drop-in-pcb.kicad_pcb from above]

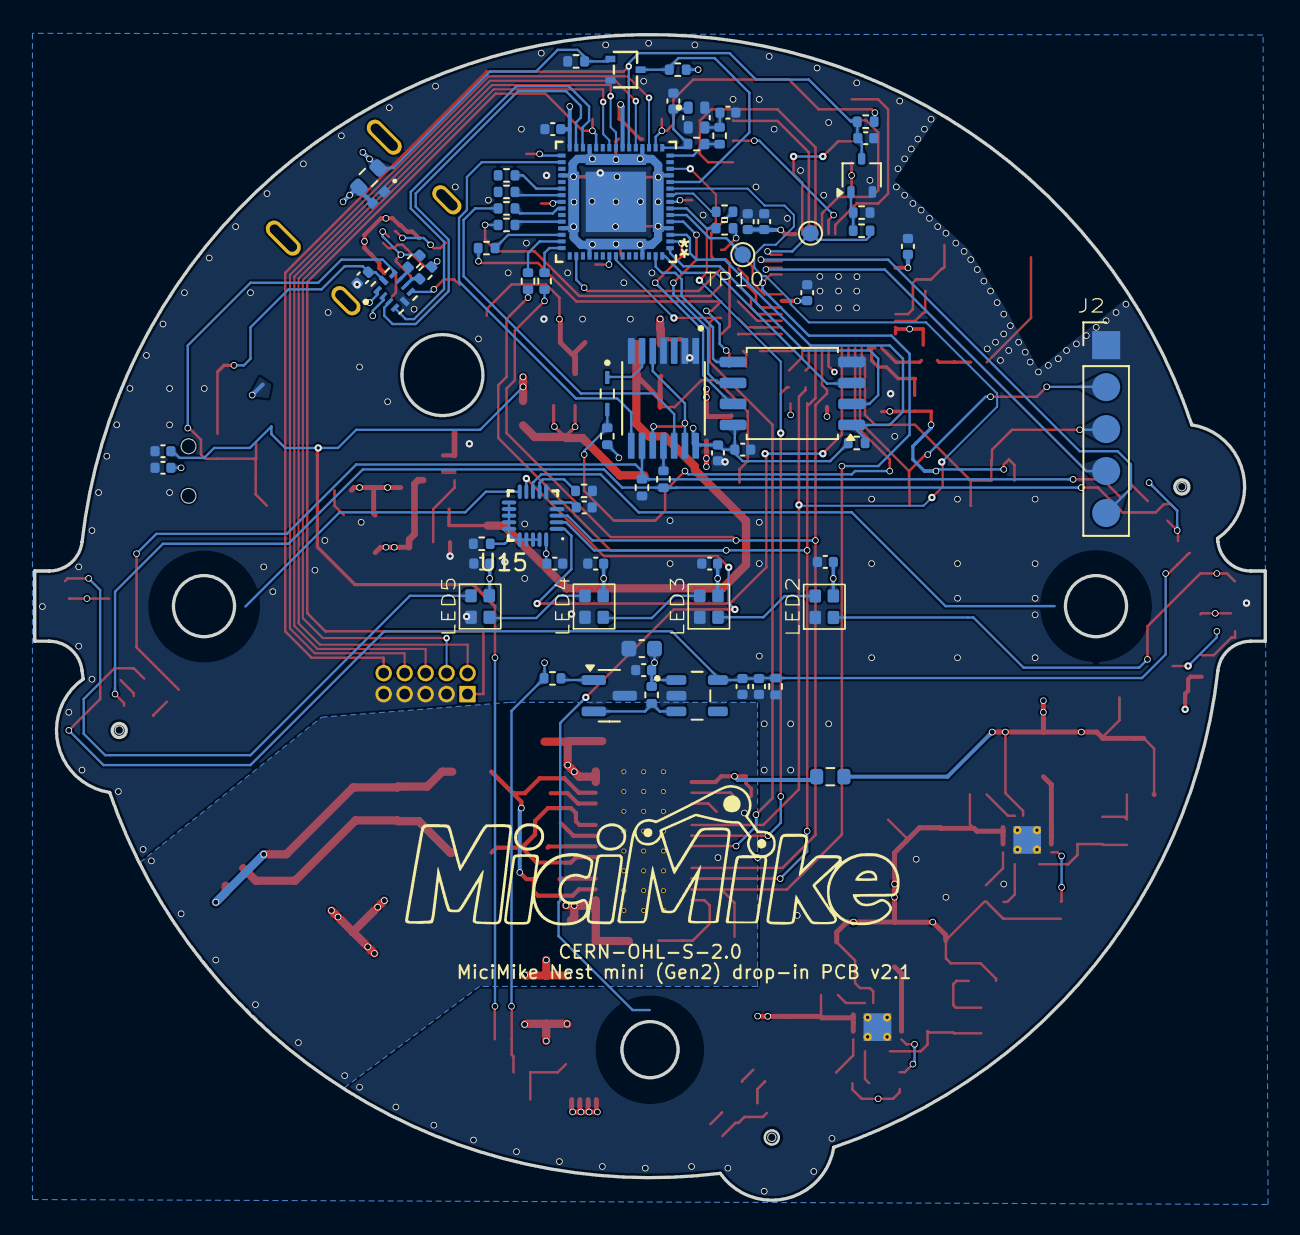
[picture p7: board nest-mini-v2-drop-in-pcb.kicad_pcb from below]

Board: 4 copper layers, 74.5 x 70.6 mm, 245 parts (71 on the bottom side), 147 nets.
