trystendsmyth/nest-mini-drop-in-pcb/(commit log)

2026-09-26 v2-fix: issue #53 fixes on the v2 hardware (XMOS 0.9V buck, Voice PE I2S roles, U12, JTAG header, TAS5805M ADR, LED level shift, routing bugs)
    Based on 7de6eec (v2 hardware), without the ESP32-C6. See CHANGES-v2fix.md for the full list, references and known limitations. Untested candidate: needs layout review before fabrication.
    [audio.kicad_sch, leds.kicad_sch, nest-mini-v2-drop-in-pcb.kicad_pcb, power_handling.kicad_sch, xmos.kicad_sch]
2026-09-27 v2.1: octilinear re-route of added tracks, bundled JTAG, TI-style buck layout, v2.1 silkscreen
    All tracks added in v2-fix re-routed at 0/45/90 deg with no mid-trace splits; branches only at pads or vias. JTAG runs as one parallel bundle (J4 moved to the top side). Buck converter re-laid with power polygons. XU316_RST moved to GPIO21, LED data to GPIO4, X1D11 MCLK left unconnected; MiciMike.yaml updated to match. Silkscreen and title blocks now say v2.1. KiCad 9 DRC with schematic parity shows only the items already on the v2 board. See CHANGES-v2fix.md.
    Claude-Session: https://claude.ai/code/session_01DBYfebaHp5UuC2Xws8yAJw
    [audio.kicad_sch, esp32.kicad_sch, leds.kicad_sch, nest-mini-v2-drop-in-pcb.kicad_pcb, nest-mini-v2-drop-in-pcb.kicad_sch, power_handling.kicad_sch, xmos.kicad_sch]
