trystendsmyth/nest-mini-drop-in-pcb/(notices)

Notices in the files:
nest-mini-v2-drop-in-pcb.kicad_pcb:
CERN-OHL-S-2.0
